abritten/dRehmFlight-StantonModel-VTOL/Resources/Specs/Circuit.pdf

# VTOL V1 Circuit

# Drew Britten

2/1/2023

# Higher Level Summary

4S Battery
14.8V, 120C
13.2v - 16.8V

4:1 ESC
F55A

#1 5V

Regulator
2.5A

Teensy 4.1
Flight
Controller

Radio
Receiver

#1 F80 Motor

2200KV

#2 5V

Regulator
2.5A

#3 5V

Regulator
2.5A

#2 F80 Motor

2200KV

F80 Motor Pitch

#1 25Kg Servo

#2 25Kg Servo

MG90S
2Kg Servo

Tail
Elevator

Thrusters

# Higher Level Location

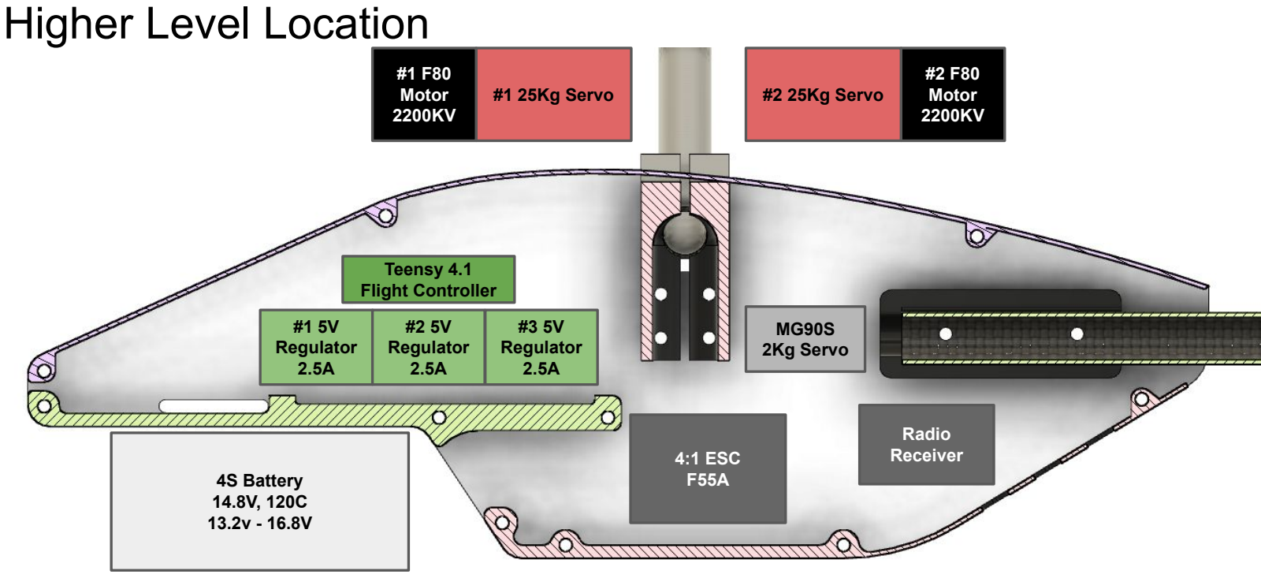
[picture p6: page 3]

4S Battery
14.8V, 120C
13.2v - 16.8V

4:1 ESC
F55A

#1 5V

Regulator
2.5A

Teensy 4.1
Flight Controller

Radio
Receiver

#1 25Kg Servo

#1 F80

Motor
2200KV

#2 5V

Regulator
2.5A

#3 5V

Regulator
2.5A

#2 F80

Motor
2200KV

#2 25Kg Servo

MG90S
2Kg Servo

# Teensy I/O Summary

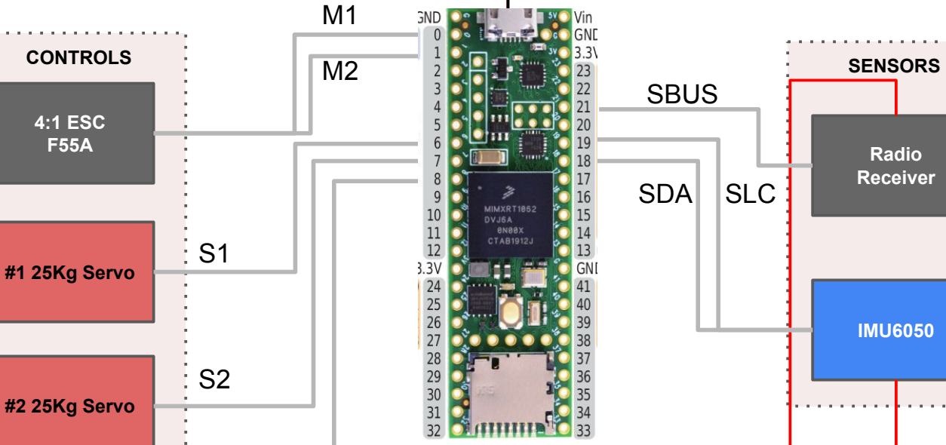
[picture p7: figure]
CONTROLS; SENSORS; 4:1 ESC F55A; Radio Receiver; #1 25Kg Servo; #2 25Kg Servo; IMU6050; SDA; SLC; SBUS

#1 5V

Regulator
2.5A

MG90S
2Kg Servo

S3

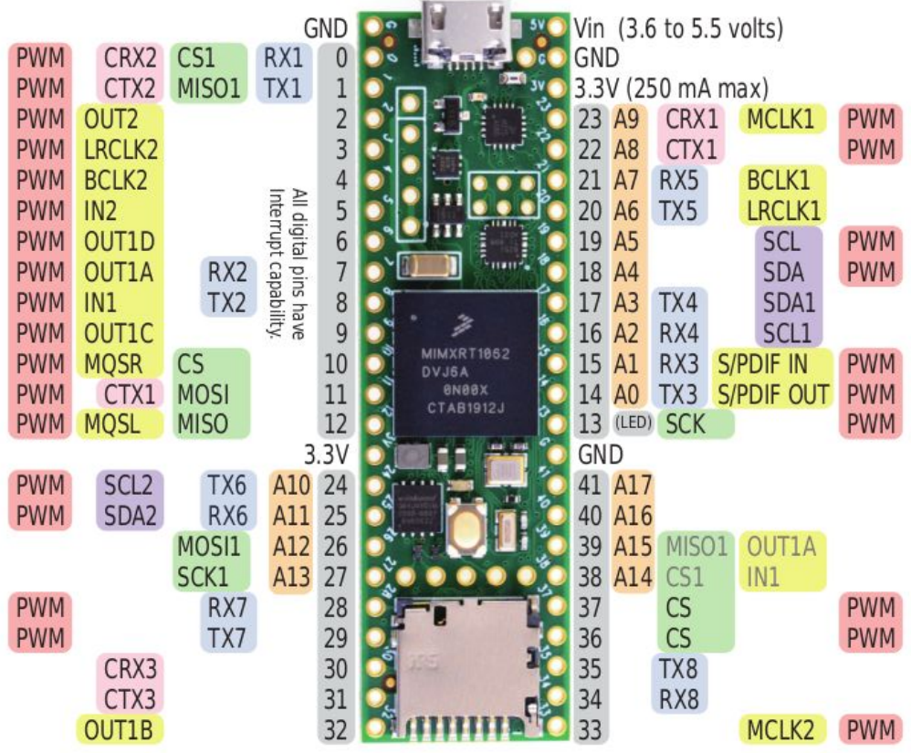
[picture p8: page 5]
