abritten/dRehmFlight-StantonModel-VTOL/Resources/arduino_DJI_03_RC_ARM-main/DJI_O3_Schem.png

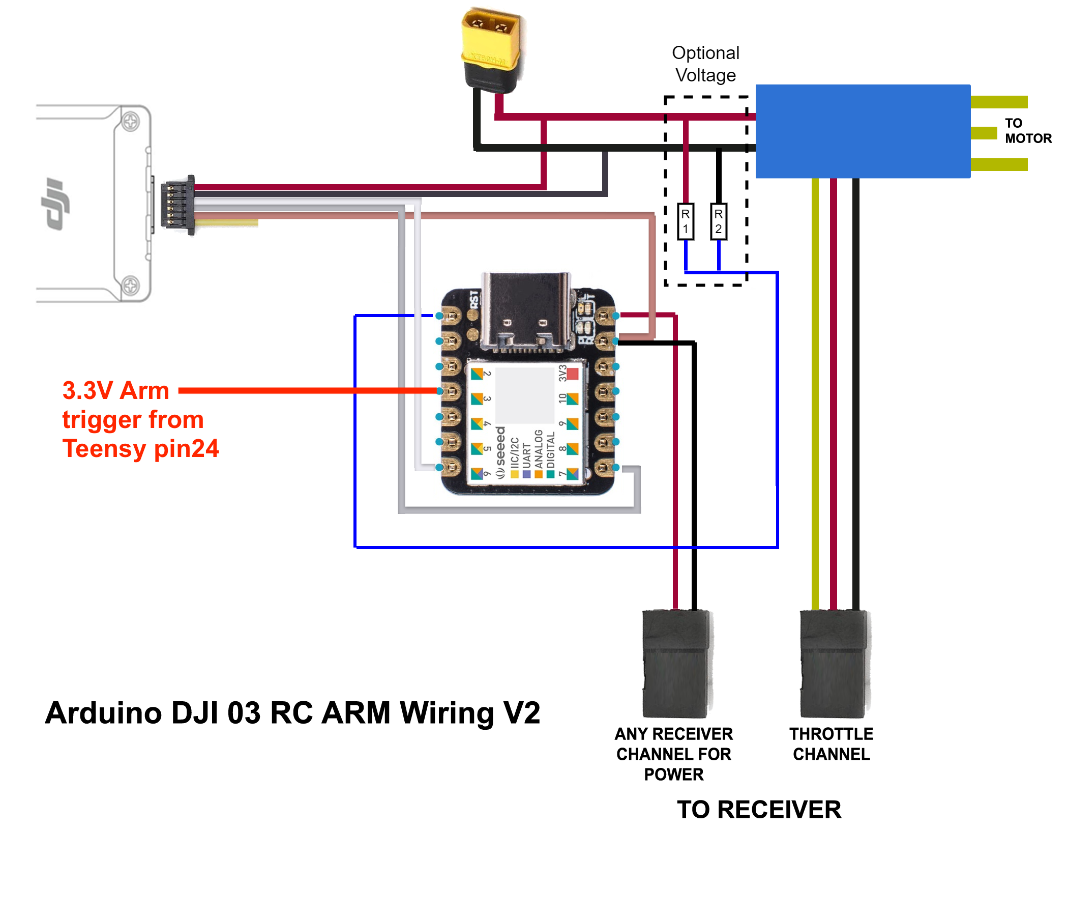
Resources/arduino_DJI_03_RC_ARM-main/DJI_O3_Schem.png
