abritten/dRehmFlight-StantonModel-VTOL/Resources/Images/CAD.png

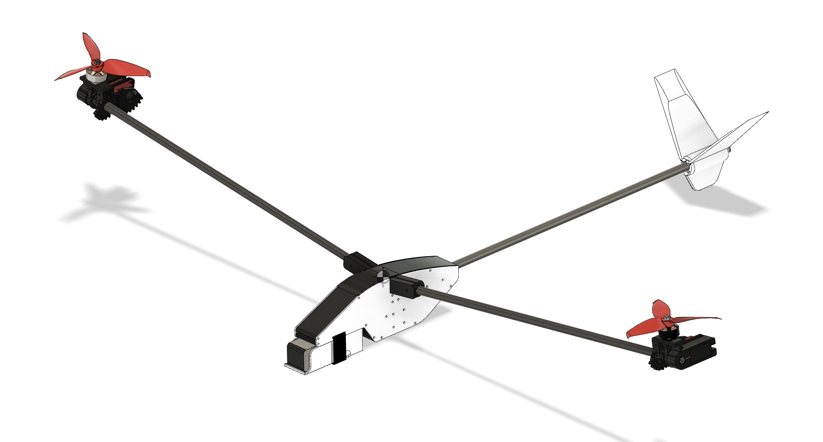
Resources/Images/CAD.png
