abritten/dRehmFlight-StantonModel-VTOL/Resources/Images/field.jpg

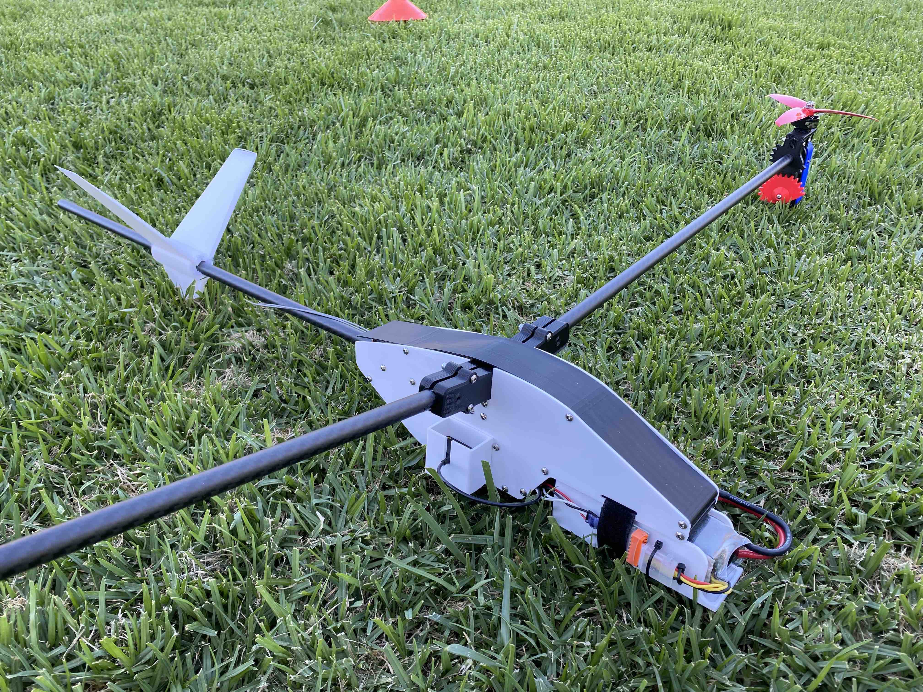
Resources/Images/field.jpg
