abritten/dRehmFlight-StantonModel-VTOL/Resources/Images/Hardware/DJIO3_CAD/1.png

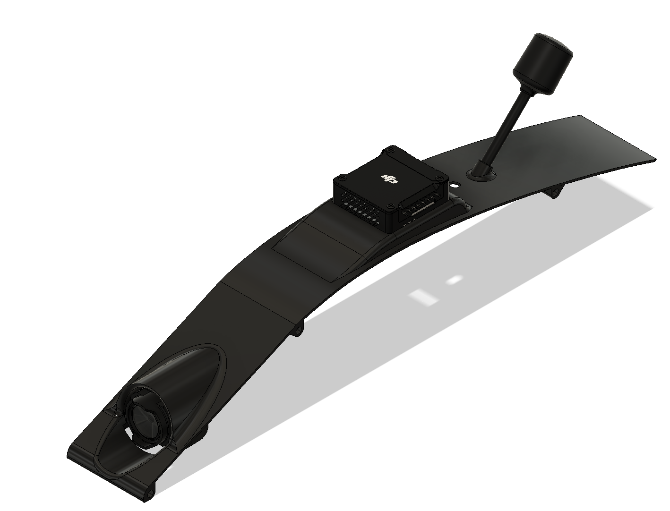
Resources/Images/Hardware/DJIO3_CAD/1.png
