abritten/dRehmFlight-StantonModel-VTOL/Resources/Images/Hardware/DJIO3_CAD/2.png

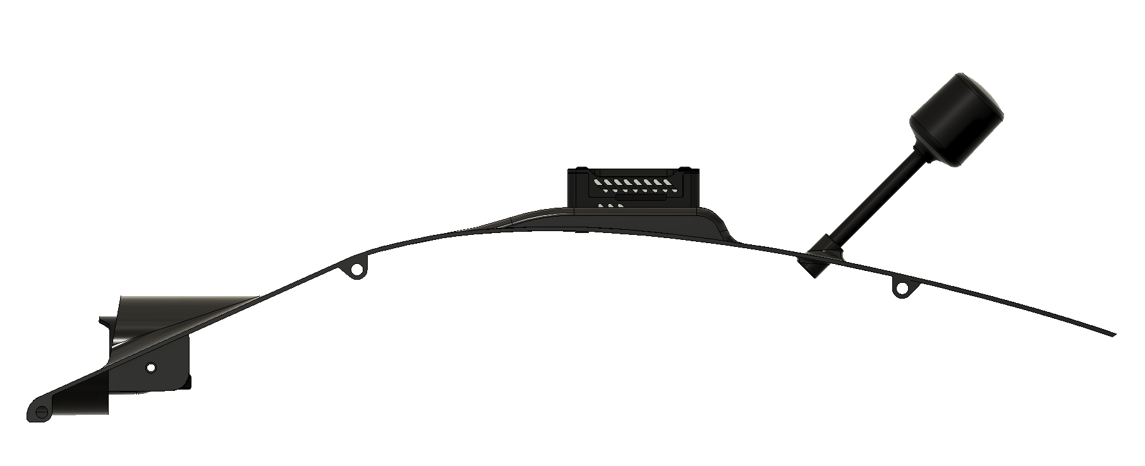
Resources/Images/Hardware/DJIO3_CAD/2.png
