abritten/dRehmFlight-StantonModel-VTOL/Resources/Images/Hardware/DJIO3_CAD/3.png

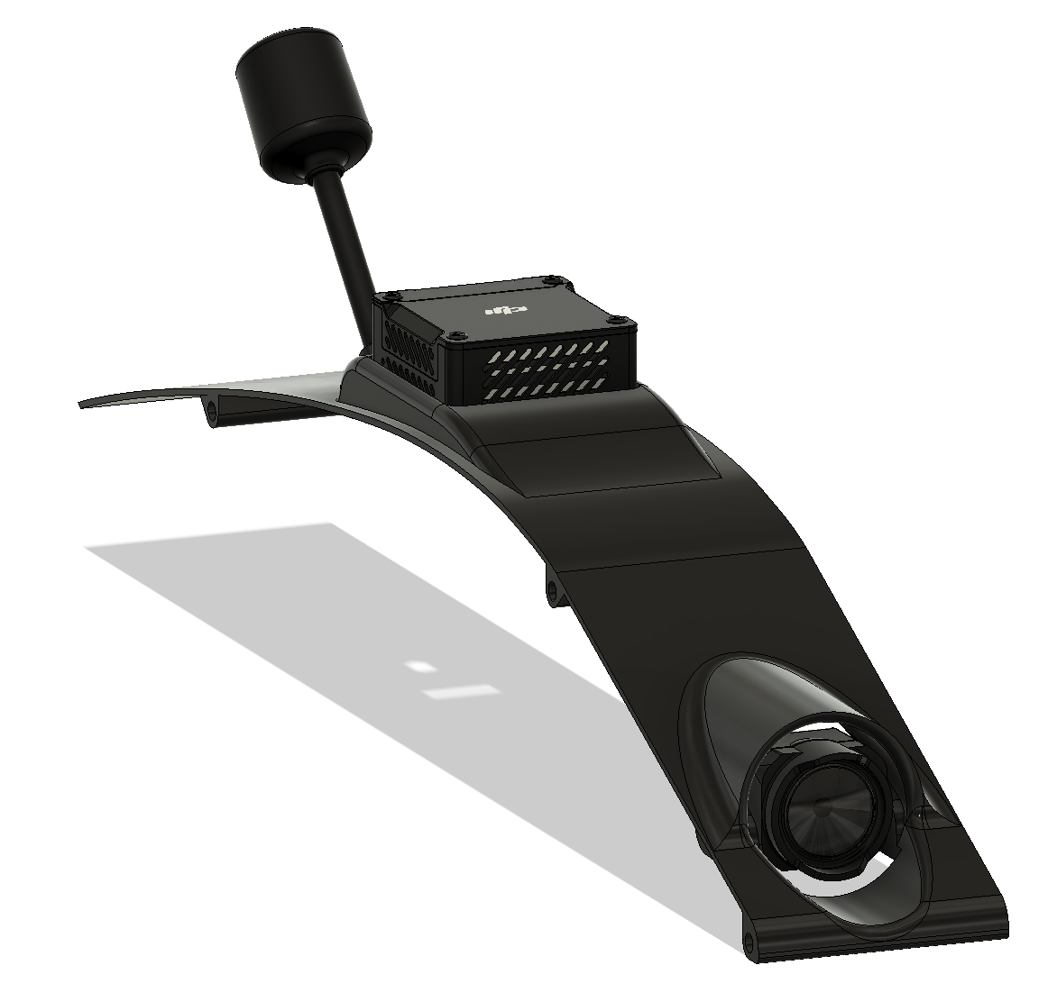
Resources/Images/Hardware/DJIO3_CAD/3.png
