abritten/dRehmFlight-StantonModel-VTOL/Resources/Images/plane.jpeg

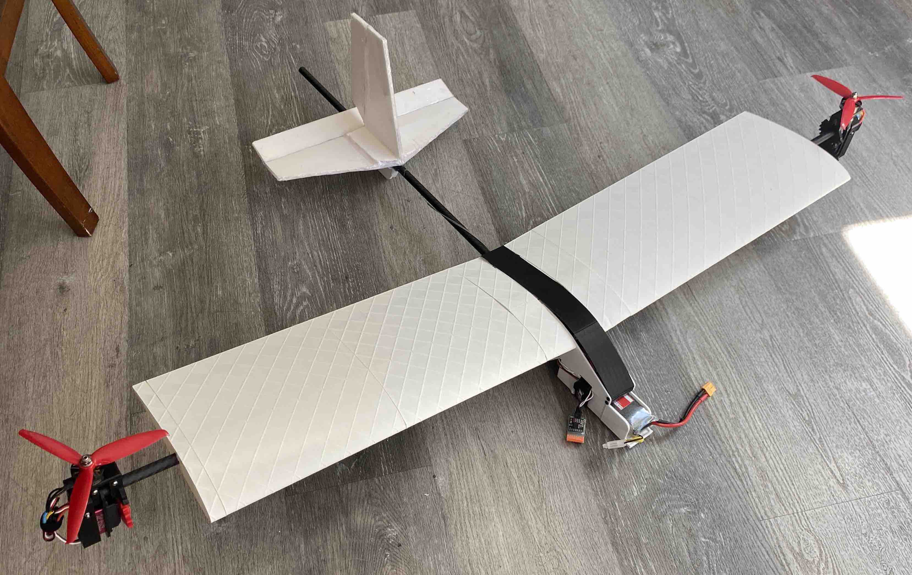
Resources/Images/plane.jpeg
