abritten/dRehmFlight-StantonModel-VTOL/Resources/Images/planeCAD.png

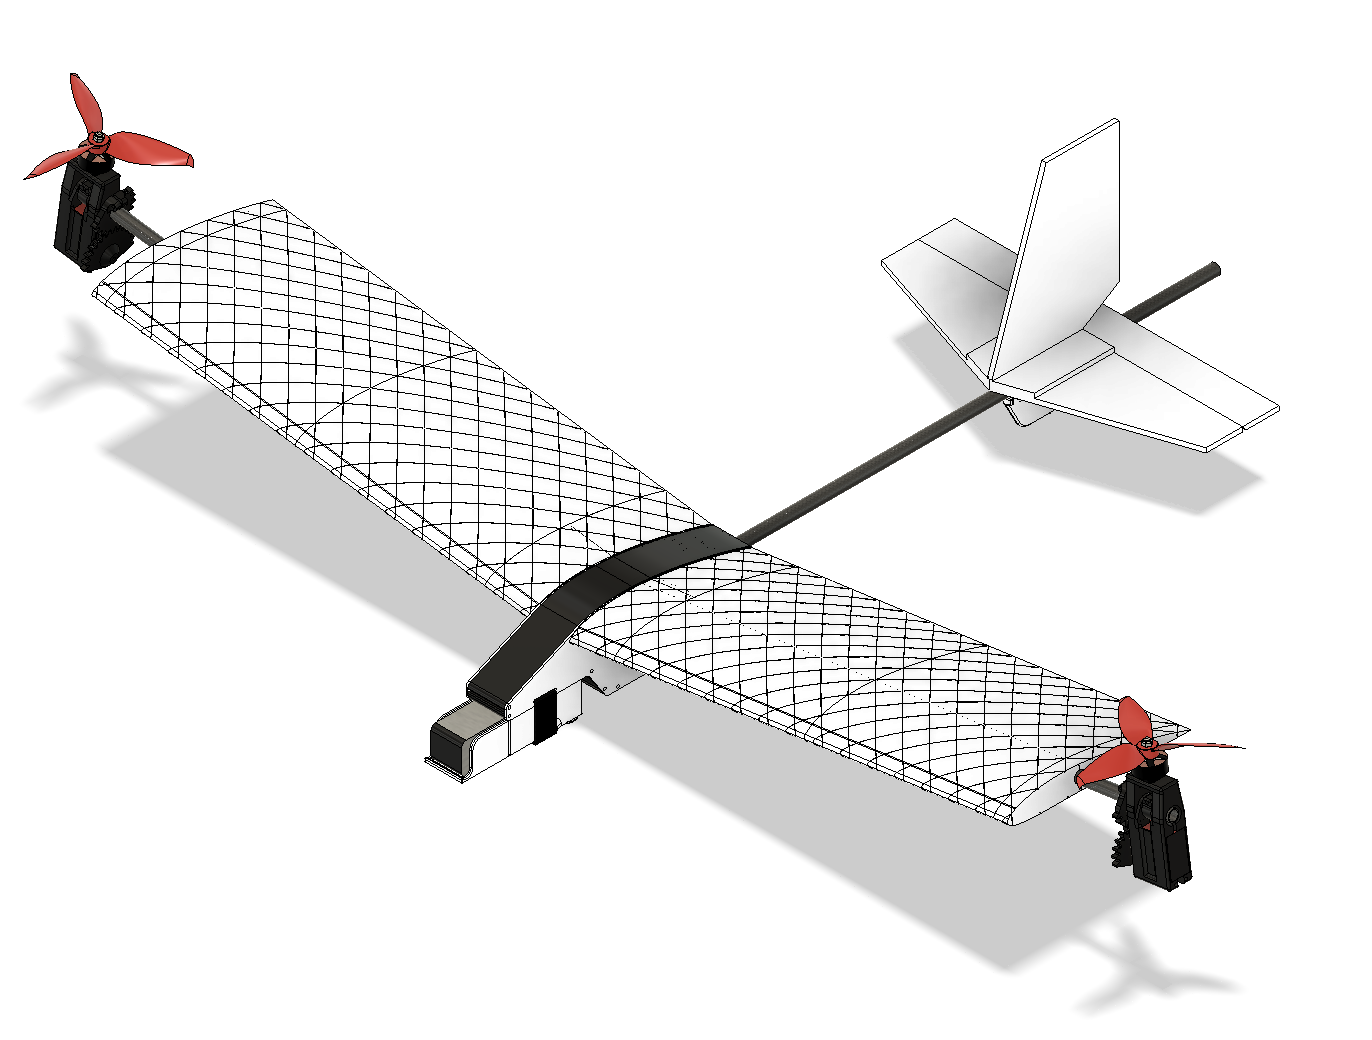
Resources/Images/planeCAD.png
