abritten/dRehmFlight-StantonModel-VTOL/Resources/Specs/BOM.pdf

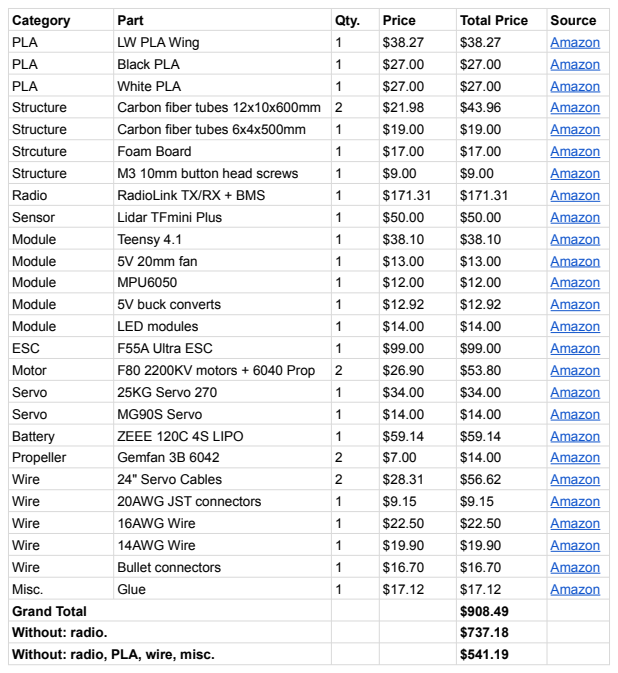
[picture p29: page 1]
Category; Part; Qty.; Price; Total Price; Source; PLA; LW PLA Wing; Amazon; Black PLA; White PLA; Structure; Carbon fiber tubes 12x10x600mm 2; Carbon fiber tubes 6x4x500mm; Strcuture; Foam Board; M3 10mm button head screws; Radio; RadioLink TX/RX + BMS; Sensor; Lidar TFmini Plus; Module; Teensy 4.1; 5V 20mm fan; MPU6050; 5V buck converts; LED modules; ESC; F55A Ultra ESC; Motor; F80 2200KV motors + 6040 Prop; Servo; 25KG Servo 270; MG90S Servo; Battery; ZEEE 120C 4S LIPO; Propeller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
