abritten/dRehmFlight-StantonModel-VTOL/(commit log)

2023-08-22 Edited README.md and firmware. Updated datasheet and radiolink settings. renamed Circuit.zip to Modules.zip. added gitignore.
2023-09-24 Cleaned up CH6 handling and PLANE - DRONE - GROUND handling. Armed status and LED blink are also debugged.
2023-09-25 Reveresed servo commands and calibrated mervo configuration and range. Calibrated elevator servo commands and range.
2023-09-25 Max pitch set to 34 degrees. Ki roll reduced to 0.01 to prevent windup roll angle.
    [dRehmFlight_Teensy_BETA_1.3.ino]
2023-12-04 Changed PID tuning back to drone mode.
2023-12-19 Updated README, Datasheet and BOM. Updated plane images.
2023-12-19 Added new output pin 24 from Teensy to digital pin 3 SAMD21 to enable/disable DJI O3 full power mode. Added DJI O3 CAD pictures and SAMD21 subfolder with code. Updated readme.
2024-12-01 Changed O3 arm to pin 12 servo.
2024-12-23 Modified forward flight to fixed PID pitch value. Elevator authority continues to induce oscillation.
    [dRehmFlight_Teensy_BETA_1.3.ino]
